demonday/immersion-controller/hardware/case/Front.stl

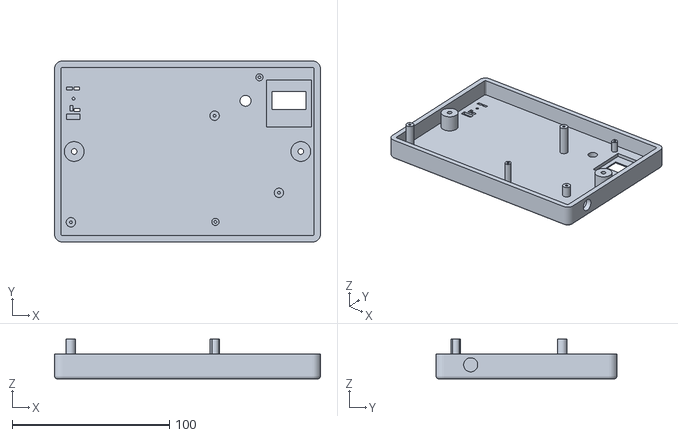
[picture p1: CAD file, 2023-11-17]
hardware/case/Front.stl
169.0 x 115.0 x 25.4
