demonday/immersion-controller/hardware/kicad_libraries/PC817XI/PC817XI.step

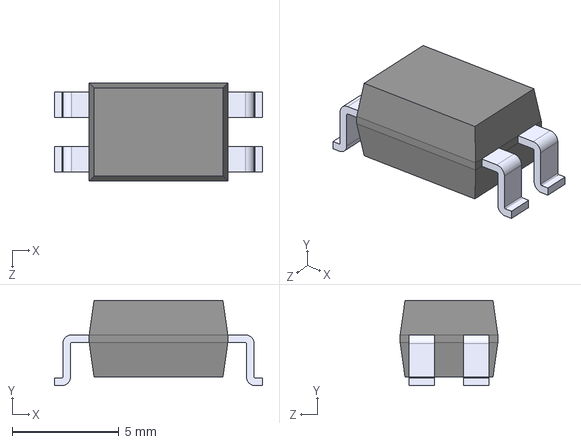
[picture p2: CAD file, 2023-11-13]
hardware/kicad_libraries/PC817XI/PC817XI.step
9.75 x 4.00 x 4.58 mm
