demonday/immersion-controller/hardware/mcu_board/mcu_board.kicad_pcb

## KiCad design hardware/mcu_board/mcu_board.kicad_pcb (2023-12-05)

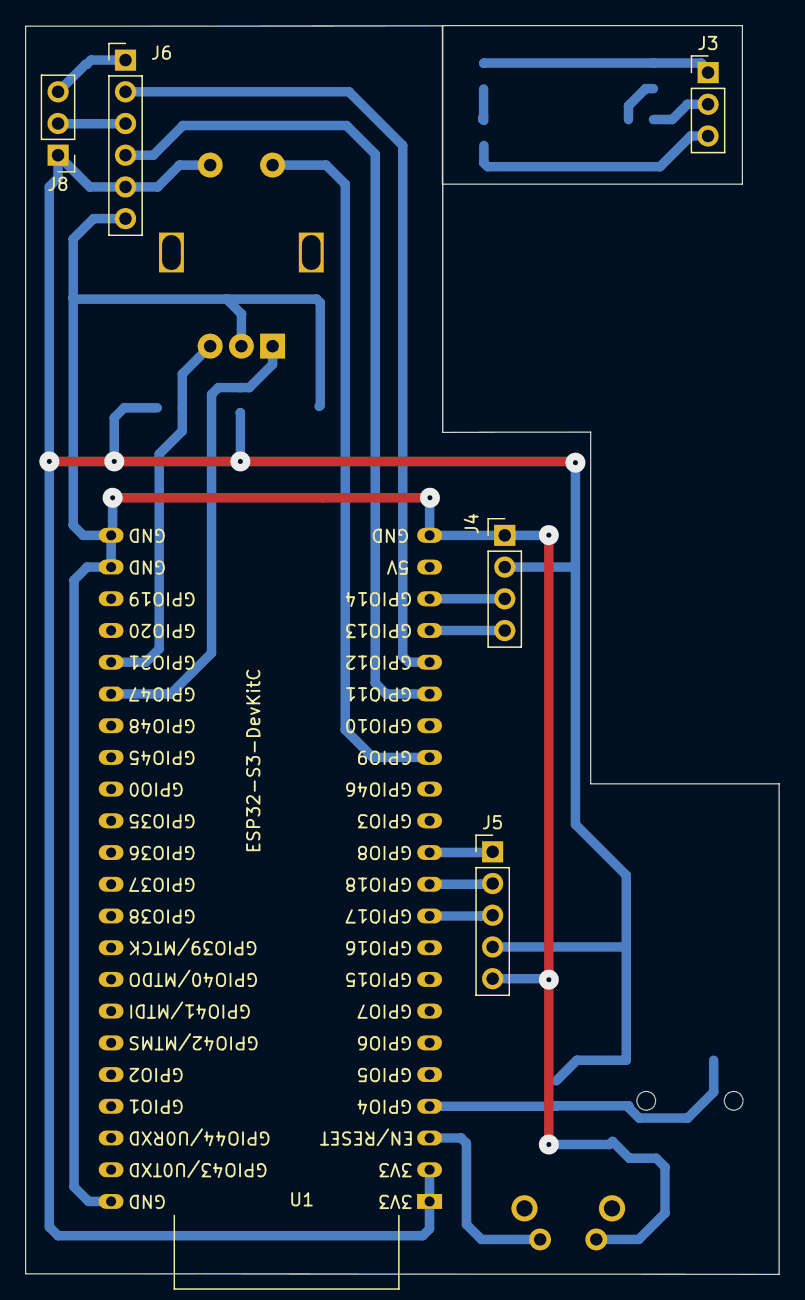
[picture p3: board mcu_board.kicad_pcb from above]

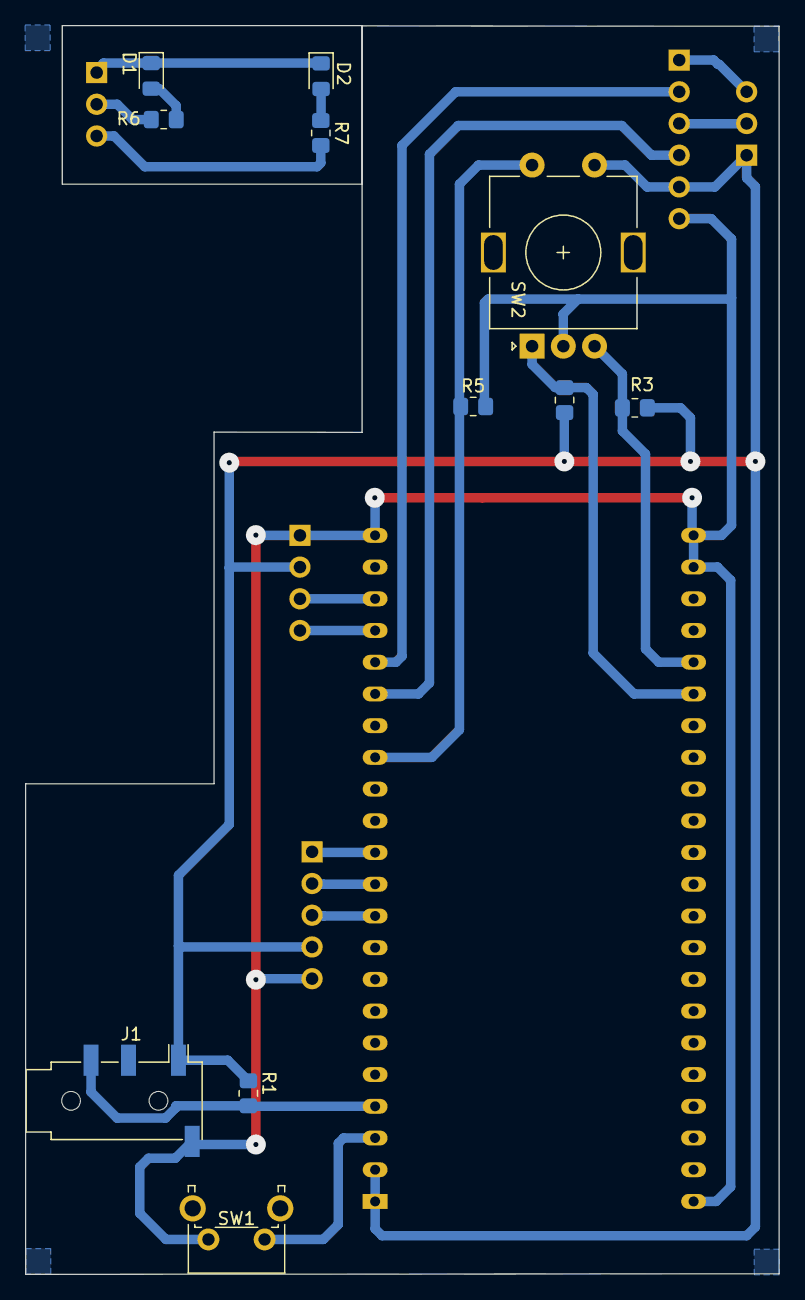
[picture p4: board mcu_board.kicad_pcb from below]

Board: 2 copper layers, 60.3 x 100.0 mm, 17 parts (11 on the bottom side), 21 nets.

Parts:
D1: LED_BT; D_0805_2012Metric_Pad1.15x1.40mm_HandSolder
D2: LED_OP; D_0805_2012Metric_Pad1.15x1.40mm_HandSolder
J1: TEMP; Jack_3.5mm_PJ320D_Horizontal
J3: LEDS_IN; PinHeader_1x03_P2.54mm_Vertical
J4: DISPLAY; PinHeader_1x04_P2.54mm_Vertical
J5: RTC; PinHeader_1x05_P2.54mm_Vertical
J6: MCU; PinHeader_1x06_P2.54mm_Vertical
J8: LEDS_OUT; PinHeader_1x03_P2.54mm_Vertical
R1: 4k7; R_0805_2012Metric_Pad1.20x1.40mm_HandSolder
R2, R3, R5: 10K; R_0805_2012Metric_Pad1.20x1.40mm_HandSolder
R6, R7: 330R; R_0805_2012Metric_Pad1.20x1.40mm_HandSolder
SW1: RESET; SW_Tactile_SPST_Angled_PTS645Vx39-2LFS
SW2: RotaryEncoder_Switch; RotaryEncoder_Alps_EC11E-Switch_Vertical_H20mm
U1: ESP32-S3-DevKitC

Connections:
+3.3V: J1.T, J4.2, J5.4, J6.5, J8.1, R1.2, R2.1, R3.1, SW2.S1, U1.1 (3V3), U1.2 (3V3)
DISPLAY_SCL: J4.3, U1.20 (GPIO14/ADC2_CH3)
DISPLAY_SDA: J4.4, U1.19 (GPIO13/ADC2_CH2)
GND: J1.S, J4.1, J5.5, J6.6, R5.2, SW1.2 (B), SW2.C, U1.22 (GND), U1.23 (GND), U1.24 (GND), U1.44 (GND)
LED_BOOST: J6.3, J8.2
LED_OFFPEAK: J6.1, J8.3
unnamed: D1.2 (A), R6.1
unnamed: D1.1 (K), D2.1 (K), J3.1
unnamed: D2.2 (A), R7.1
unnamed: J3.2, R6.2
unnamed: J3.3, R7.2
RELAY_BOOST: J6.4, U1.17 (GPIO11/ADC2_CH0)
RELAY_OFFPEAK: J6.2, U1.18 (GPIO12/ADC2_CH1)
RESET: SW1.1 (A), U1.3 (CHIP_PU)
ROT_CLK: R2.2, SW2.A, U1.28 (GPIO47)
ROT_DT: R3.2, SW2.B, U1.27 (GPIO21)
ROT_SW: R5.1, SW2.S2, U1.15 (GPIO9/ADC1_CH8)
RTC_SCK: J5.2, U1.11 (GPIO18/ADC2_CH7)
RTC_SDA: J5.3, U1.10 (GPIO17/ADC2_CH6)
RTC_SQW: J5.1, U1.12 (GPIO8/ADC1_CH7)
WATERTEMP_DATA: J1.R2, R1.1, U1.4 (GPIO4/ADC1_CH3)
