demonday/immersion-controller/hardware/power_board/power_board.kicad_pcb

## KiCad design hardware/power_board/power_board.kicad_pcb (2023-11-27)

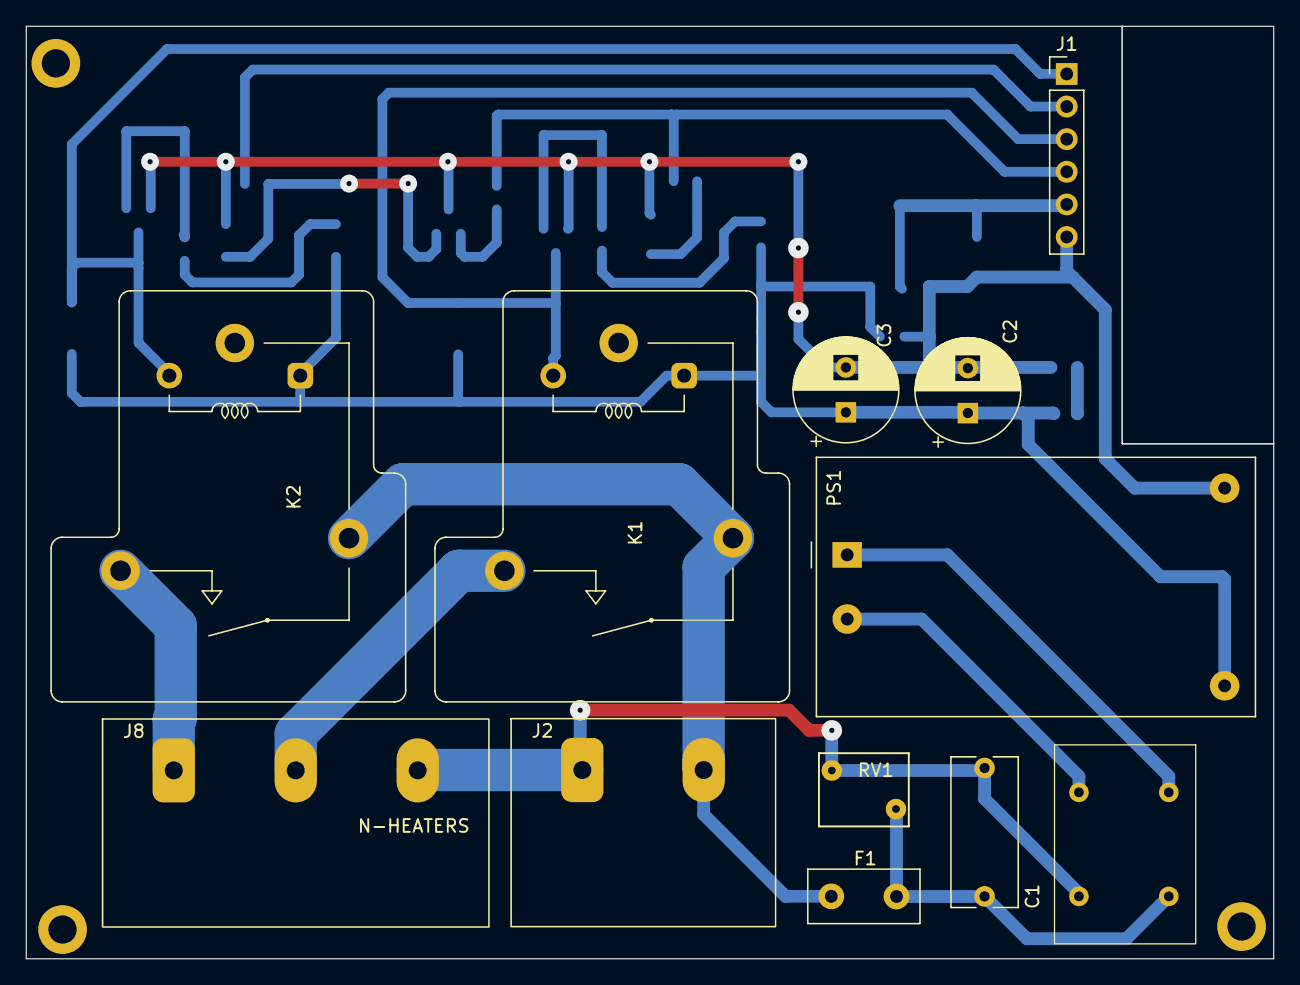
[picture p5: board power_board.kicad_pcb from above]

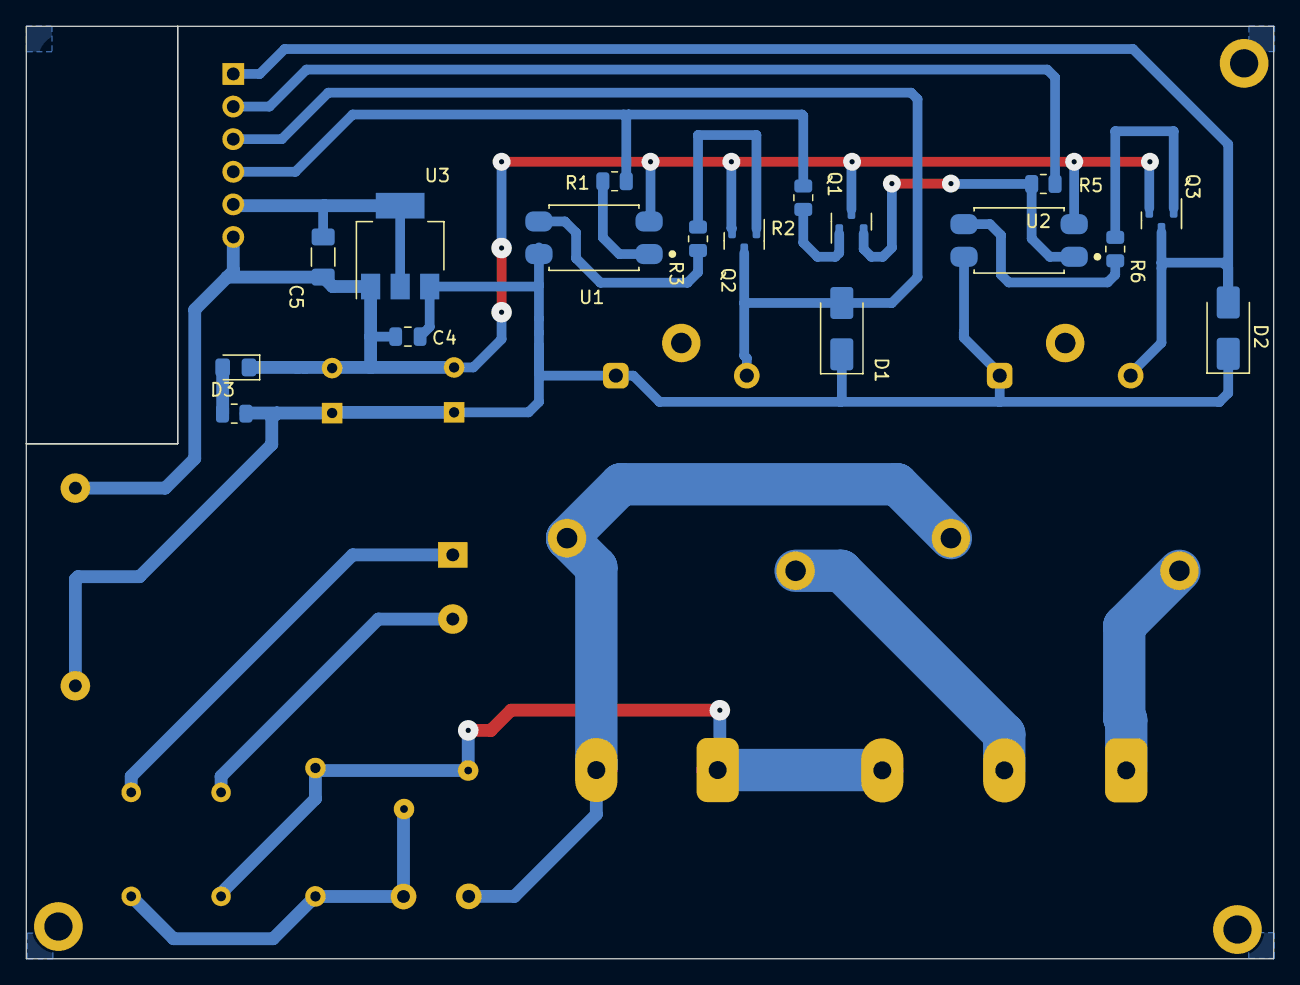
[picture p6: board power_board.kicad_pcb from below]

Board: 2 copper layers, 97.2 x 72.6 mm, 29 parts (17 on the bottom side), 22 nets.

Parts:
C1: 0.1uF; C_Rect_L11.5mm_W5.0mm_P10.00mm_MKT
C2: 470uF; CP_Radial_D8.0mm_P3.50mm
C3: 1uF; CP_Radial_D8.0mm_P3.50mm
C4: 10uF; C_0805_2012Metric
C5: 22uF; C_1206_3216Metric_Pad1.33x1.80mm_HandSolder
D1, D2: US1M; D_SMA
D3: LED; LED_0805_2012Metric_Pad1.15x1.40mm_HandSolder
F1: 500 mA; Fuse_Littelfuse_395Series
J1: MCU; PinHeader_1x06_P2.54mm_Vertical
J2: MAINS_IN; HB9500-9.5-2P
J8: HEATER; HB9500-9.5-3P
K1: BOOST; Relay_SPST_RAYEX-L90A
K2: OFFPEAK; Relay_SPST_RAYEX-L90A
L1: 15mH 500mA; CHOKE UU9.8
PS1: HLK-PM01; Converter_ACDC_HiLink_HLK-PMxx
Q1, Q2, Q3: MMBT3904; SOT-23
R1, R5: 470; R_0805_2012Metric
R2: 1k; R_0805_2012Metric
R3, R6: 200; R_0805_2012Metric
R8: 330; R_0805_2012Metric
RV1: 10D561; RV_Disc_D7mm_W5.7mm_P5mm
U1, U2: PC817; SOIC254P975X460-4N
U3: AMS1117-3.3; SOT-223-3_TabPin2

Connections:
+3.3V: C5.1, J1.5, U3.2 (VO)
+5V: C2.1, C3.1, C4.1, D1.1 (K), D2.1 (K), K1.A1, K2.A1, PS1.4 (+Vout), R8.1, U1.4, U2.4, U3.3 (VI)
GND: C2.2, C3.2, C4.2, C5.2, D3.1 (K), J1.6, PS1.3 (-Vout), Q1.3 (C), Q2.2 (E), Q3.2 (E), U1.2, U2.2, U3.1 (GND)
LED_BOOST: D1.2 (A), J1.3, K1.A2, Q2.3 (C)
LED_OFFPEAK: D2.2 (A), J1.1, K2.A2, Q3.3 (C)
MAINSIN_L: F1.1, J2.2, K1.13B, K2.13B
MAINSIN_N: C1.2, J2.1, J8.3, L1.2, RV1.2
unnamed: C1.1, F1.2, L1.1, RV1.1
unnamed: D3.2 (A), R8.2
unnamed: J8.1, K2.14
unnamed: J8.2, K1.14
unnamed: L1.4, PS1.1 (AC/L)
unnamed: L1.3, PS1.2 (AC/N)
unnamed: Q1.1 (B), R2.2
unnamed: Q1.2 (E), R5.1, U2.1
unnamed: Q2.1 (B), R3.2
unnamed: Q3.1 (B), R6.2
unnamed: R1.1, U1.1
unnamed: R3.1, U1.3
unnamed: R6.1, U2.3
RELAY_BOOST: J1.4, R1.2, R2.1
RELAY_OFFPEAK: J1.2, R5.2
