demonday/immersion-controller/(commit log)

2023-07-31 First Iteration
    [immersion-controller.kicad_pcb, immersion-controller.kicad_sch, mcu.kicad_sch, output.kicad_sch, psu.kicad_sch]
2023-07-31 Fix .gitignore to ignore kicad backups
2023-08-11 Validated prototype
    [high_voltage.kicad_sch, immersion-controller.kicad_pcb, immersion-controller.kicad_sch, mcu.kicad_sch, output.kicad_sch, psu.kicad_sch]
2023-10-19 debugged prototype
    [immersion-controller.kicad_pcb, immersion-controller.kicad_sch, output.kicad_sch, psu.kicad_sch]
2023-11-11 Initial Prototype results
    [immersion-controller.kicad_pcb, immersion-controller.kicad_sch, mcu.kicad_sch, output.kicad_sch, psu.kicad_sch]
2023-11-11 rename kicad projects
    [high_voltage.kicad_sch, mcu.kicad_sch, mcu_board.kicad_pcb, mcu_board.kicad_sch, output.kicad_sch, power_board.kicad_pcb, power_board.kicad_sch, psu.kicad_sch]
2023-11-12 v2 Power/Relay PCB
    [output.kicad_sch, power_board.kicad_pcb, power_board.kicad_sch, psu.kicad_sch]
2023-11-13 Refactored PCBs for v2. See README
    [PC817XI.step, mcu.kicad_sch, mcu_board.kicad_pcb, mcu_board.kicad_sch, output.kicad_sch, power_board.kicad_pcb, power_board.kicad_sch, psu.kicad_sch]
2023-11-15 v2 layout changes to fit in bax
    [mcu.kicad_sch, mcu_board.kicad_pcb, mcu_board.kicad_sch, power_board.kicad_pcb]
2023-11-16 Laypout tweaks to fit case
    [mcu.kicad_sch, mcu_board.kicad_pcb, mcu_board.kicad_sch]
2023-11-17 v2 Boards for fabrication
    [Front.stl, mcu_board.kicad_pcb, power_board.kicad_pcb, power_board.kicad_sch]
2023-11-22 Add missing holes and fabrication marks
    [power_board.kicad_pcb, power_board.kicad_sch]
2023-11-24 minor layout tweaks
    [power_board.kicad_pcb]
2023-11-25 fix boards so they components are on the correct side lol
    [mcu.kicad_sch, mcu_board.kicad_pcb, mcu_board.kicad_sch, output.kicad_sch, power_board.kicad_pcb, power_board.kicad_sch]
2023-11-27 move screw position
    [mcu_board.kicad_pcb, power_board.kicad_pcb]
2023-12-01 minor tweaks
    [mcu.kicad_sch, mcu_board.kicad_pcb]
2023-12-05 v3 first draft
    [mcu.kicad_sch, mcu_board.kicad_pcb, output.kicad_sch]
